siredmar/tfp401_board/README.md

tfp401_board
============

Hard- and Software for TFP401 Board to connect with 40 Pin RGB LCDs
