siredmar/tfp401_board/hw/tfp401_board/tfp401_board.brd

## EAGLE design hw/tfp401_board/tfp401_board.brd (2014-12-05)

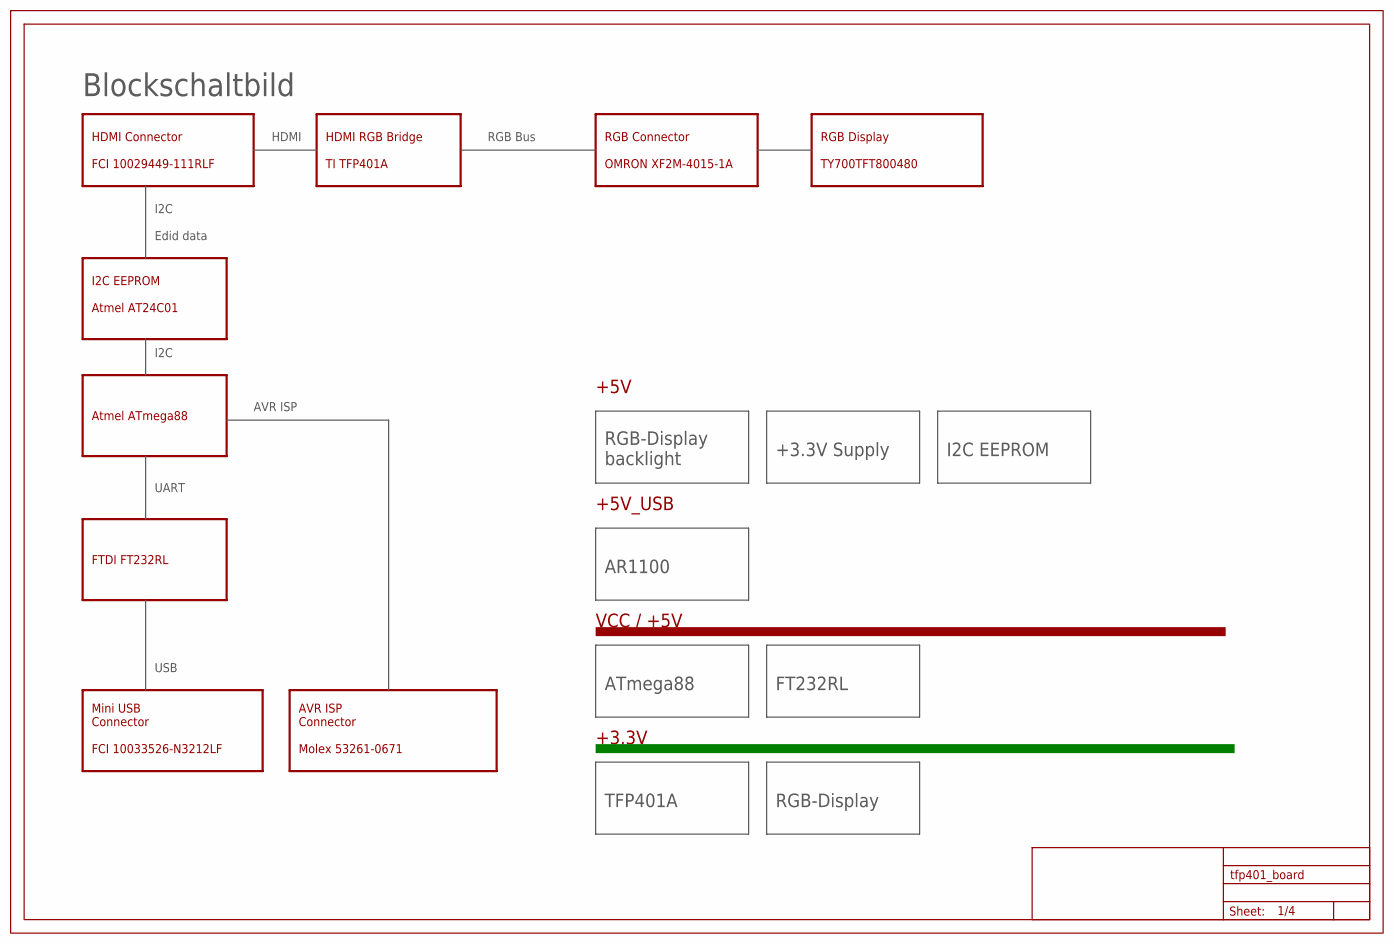
[picture p1: schematic tfp401_board.sch, sheet 1]

Parts:
U$15: FRAME_A3_LANDSCAPE; FRAME

Notes on the sheet:
HDMI Connector FCI 10029449-111RLF
RGB Display TY700TFT800480
Mini USB Connector FCI 10033526-N3212LF
AVR ISP Connector Molex 53261-0671
RGB Connector OMRON XF2M-4015-1A
HDMI RGB Bridge TI TFP401A
I2C EEPROM Atmel AT24C01
Atmel ATmega88
Edid data
RGB Bus
I2C
USB
AVR ISP
HDMI
Blockschaltbild
+3.3V
VCC / +5V
ATmega88
I2C EEPROM
FT232RL
TFP401A
FTDI FT232RL
UART
RGB-Display backlight
RGB-Display
+5V
AR1100
+5V_USB
+3.3V Supply

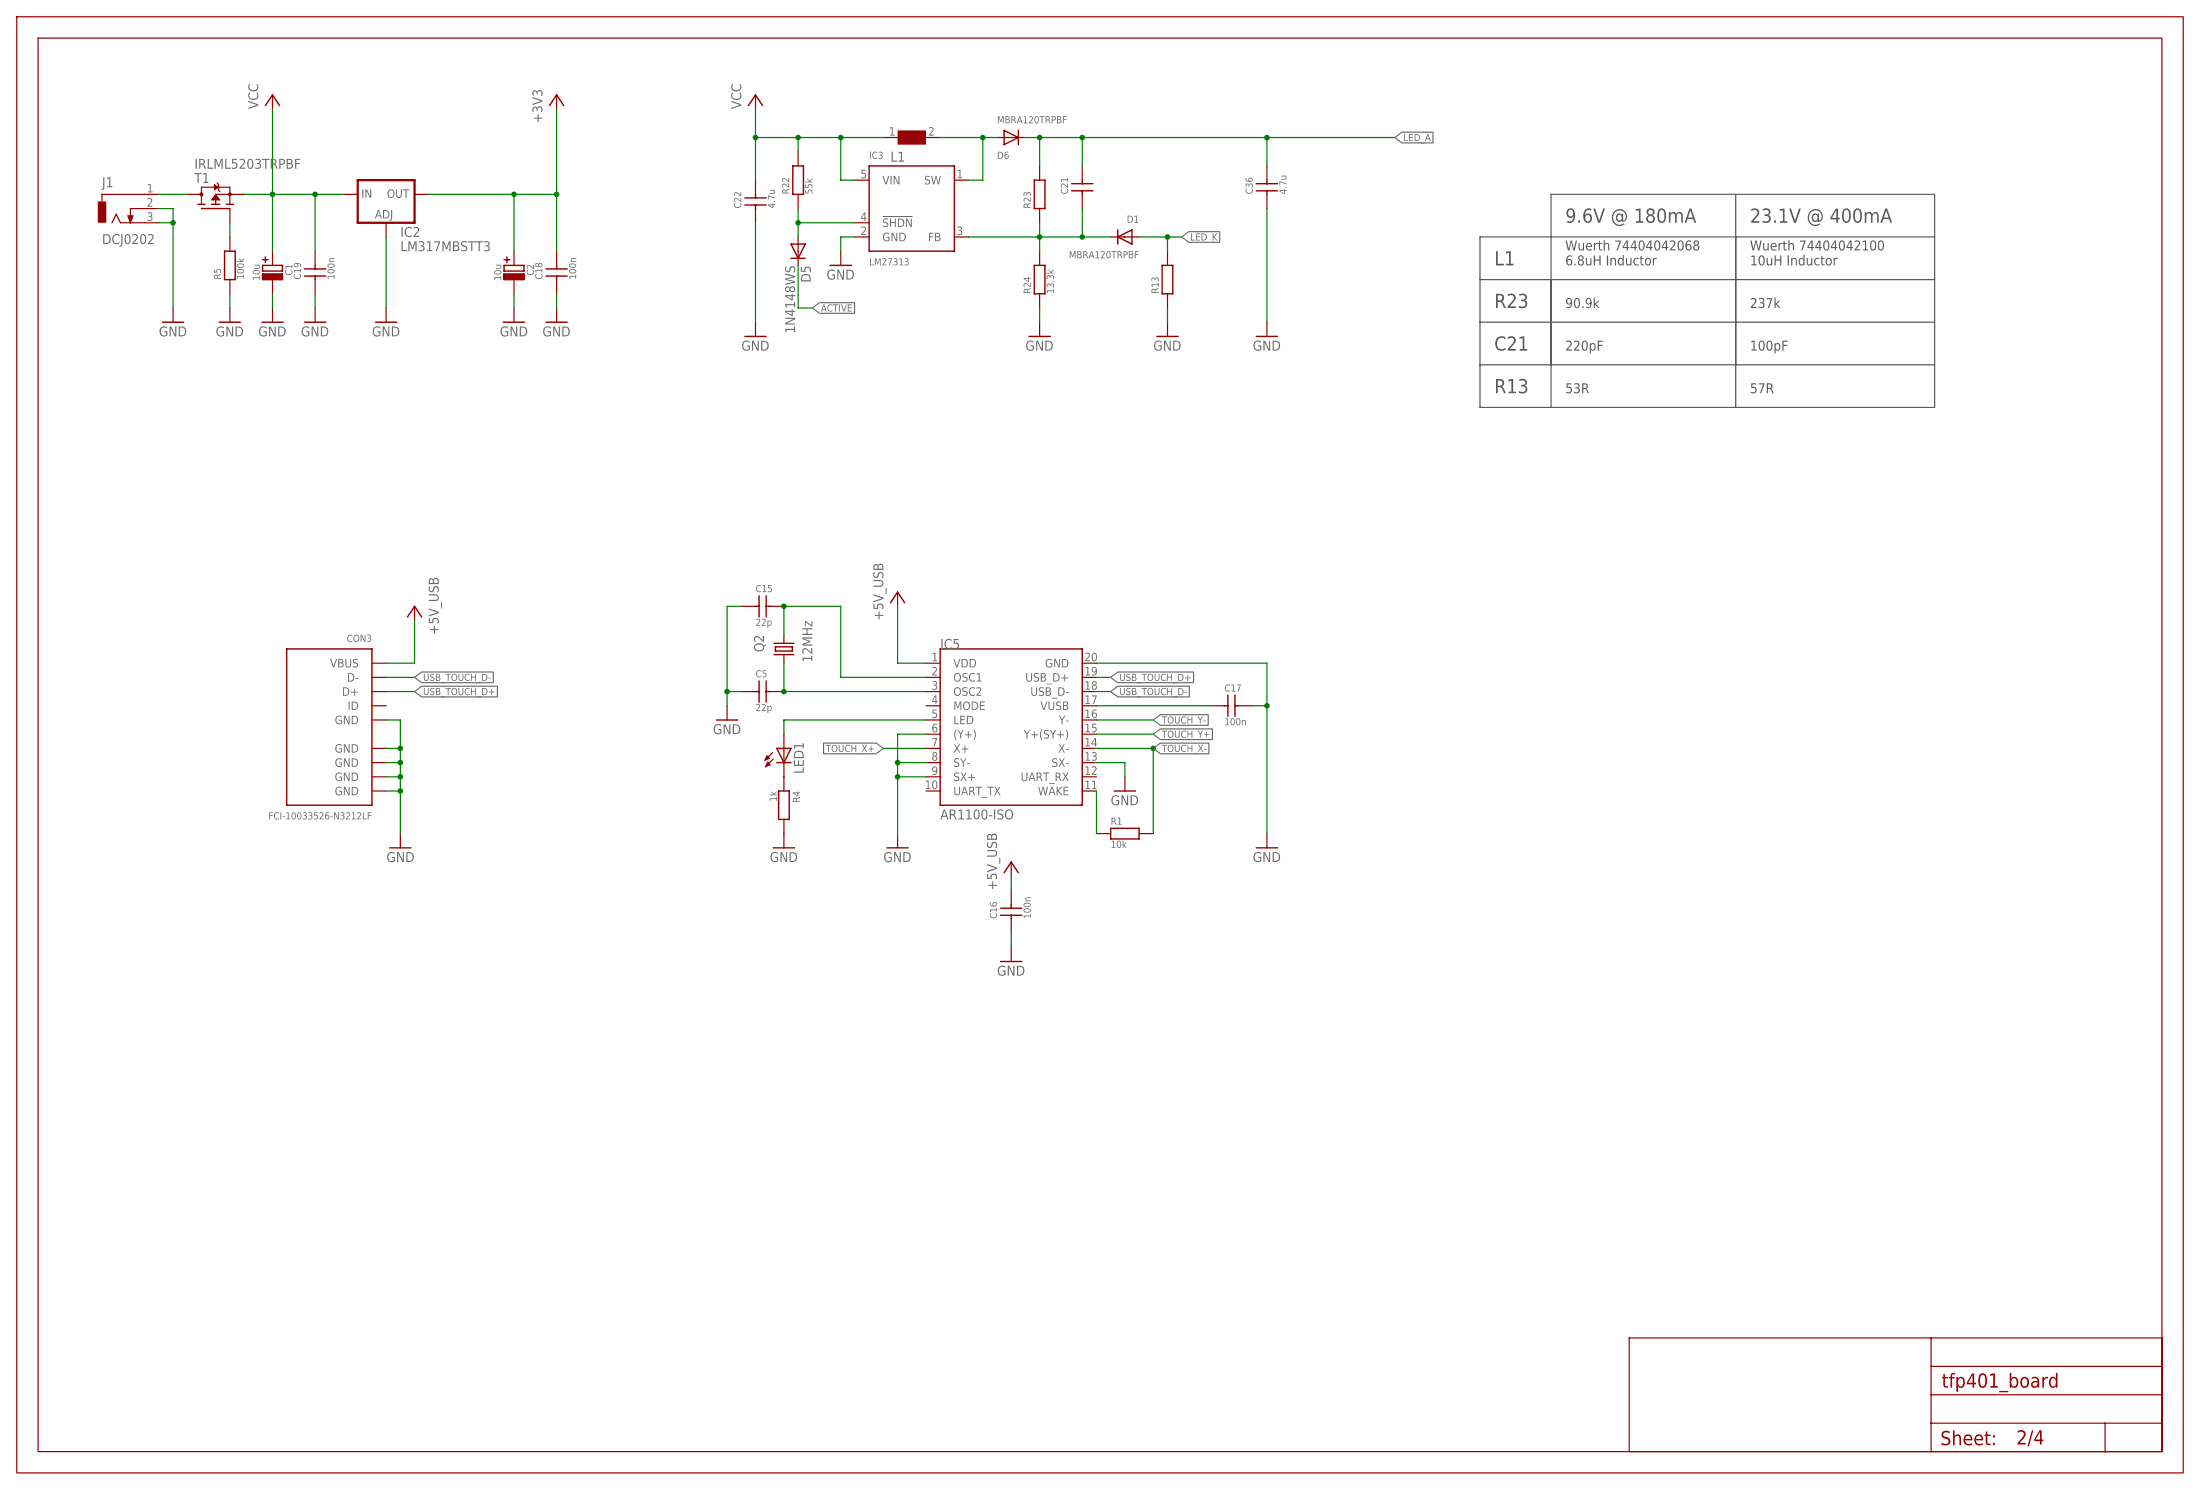
[picture p2: schematic tfp401_board.sch, sheet 2]

Parts:
C1, C2: 10u; C_POL_4X4MM
C5, C15: 22p; C0603
C16, C17, C18, C19: 100n; C0603
C21: C_SMD0603; C0603
C22, C36: 4.7u; C1206
CON3: FCI-10033526-N3212LF
D1, D6: MBRA120TRPBF; SMADIODE
D5: 1N4148WS; SOD323-W
IC2: LM317MBSTT3; SOT223
IC3: LM27313; SOT23-5
IC5: AR1100-ISO; SOIC20
J1: DCJ0202
L1: WE-LQS_4018
LED1: LEDCHIP-LED0805; CHIP-LED0805
Q2: 12MHz; HC49/USSM
R1: 10k; R0603
R4: 1k; R0603
R5: 100k; R0603
R13: R2512
R22: 55k; R0603
R23: R0603
R24: 13.3k; R0603
T1: IRLML5203TRPBF; SOT23
U$2: FRAME_A3_LANDSCAPE; FRAME

Connections:
+3V3: C2.+, C18.2, IC2.4 (OUT); also elsewhere on the board
+5V_USB: C16.2, CON3.1 (VBUS), IC5.1 (VDD)
ACTIVE: D5.C; also elsewhere on the board
GND: C1.-, C2.-, C5.1, C15.1, C16.1, C17.2, C18.1, C19.1, C22.1, C36.1, CON3.5 (GND), CON3.GND@1 (GND), CON3.GND@2 (GND), CON3.GND@3 (GND), CON3.GND@4 (GND), IC2.1 (ADJ), IC3.2 (GND), IC5.6 ((Y+)), IC5.8 (SY-), IC5.9 (SX+), IC5.13 (SX-), IC5.20 (GND), J1.2, J1.3, R4.2, R5.1, R13.1, R24.1; also elsewhere on the board
LED_A: C21.2, C36.2, D6.C, R23.2; also elsewhere on the board
LED_K: D1.A, R13.2; also elsewhere on the board
unnamed: R5.2, T1.1 (G)
unnamed: IC5.11 (WAKE), R1.1
unnamed: C17.1, IC5.17 (VUSB)
unnamed: LED1.C, R4.1
unnamed: C15.2, IC5.2 (OSC1), Q2.1
unnamed: J1.1, T1.3 (D)
unnamed: C5.2, IC5.3 (OSC2), Q2.2
unnamed: D6.A, IC3.1 (SW), L1.2
unnamed: D5.A, IC3.4 (!SHDN), R22.1
unnamed: IC5.5 (LED), LED1.A
unnamed: C21.1, D1.C, IC3.3 (FB), R23.1, R24.2
TOUCH_X+: IC5.7 (X+); also elsewhere on the board
TOUCH_X-: IC5.14 (X-), R1.2; also elsewhere on the board
TOUCH_Y+: IC5.15 (Y+(SY+)); also elsewhere on the board
TOUCH_Y-: IC5.16 (Y-); also elsewhere on the board
USB_TOUCH_D+: CON3.3 (D+), IC5.19 (USB_D+)
USB_TOUCH_D-: CON3.2 (D-), IC5.18 (USB_D-)
VCC: C1.+, C19.2, C22.2, IC2.3 (IN), IC3.5 (VIN), L1.1, R22.2, T1.2 (S); also elsewhere on the board

Notes on the sheet:
9.6V @ 180mA
23.1V @ 400mA
R23
Wuerth 74404042068 6.8uH Inductor
Wuerth 74404042100 10uH Inductor
C21
90.9k
237k
100pF
220pF
R13
57R
53R

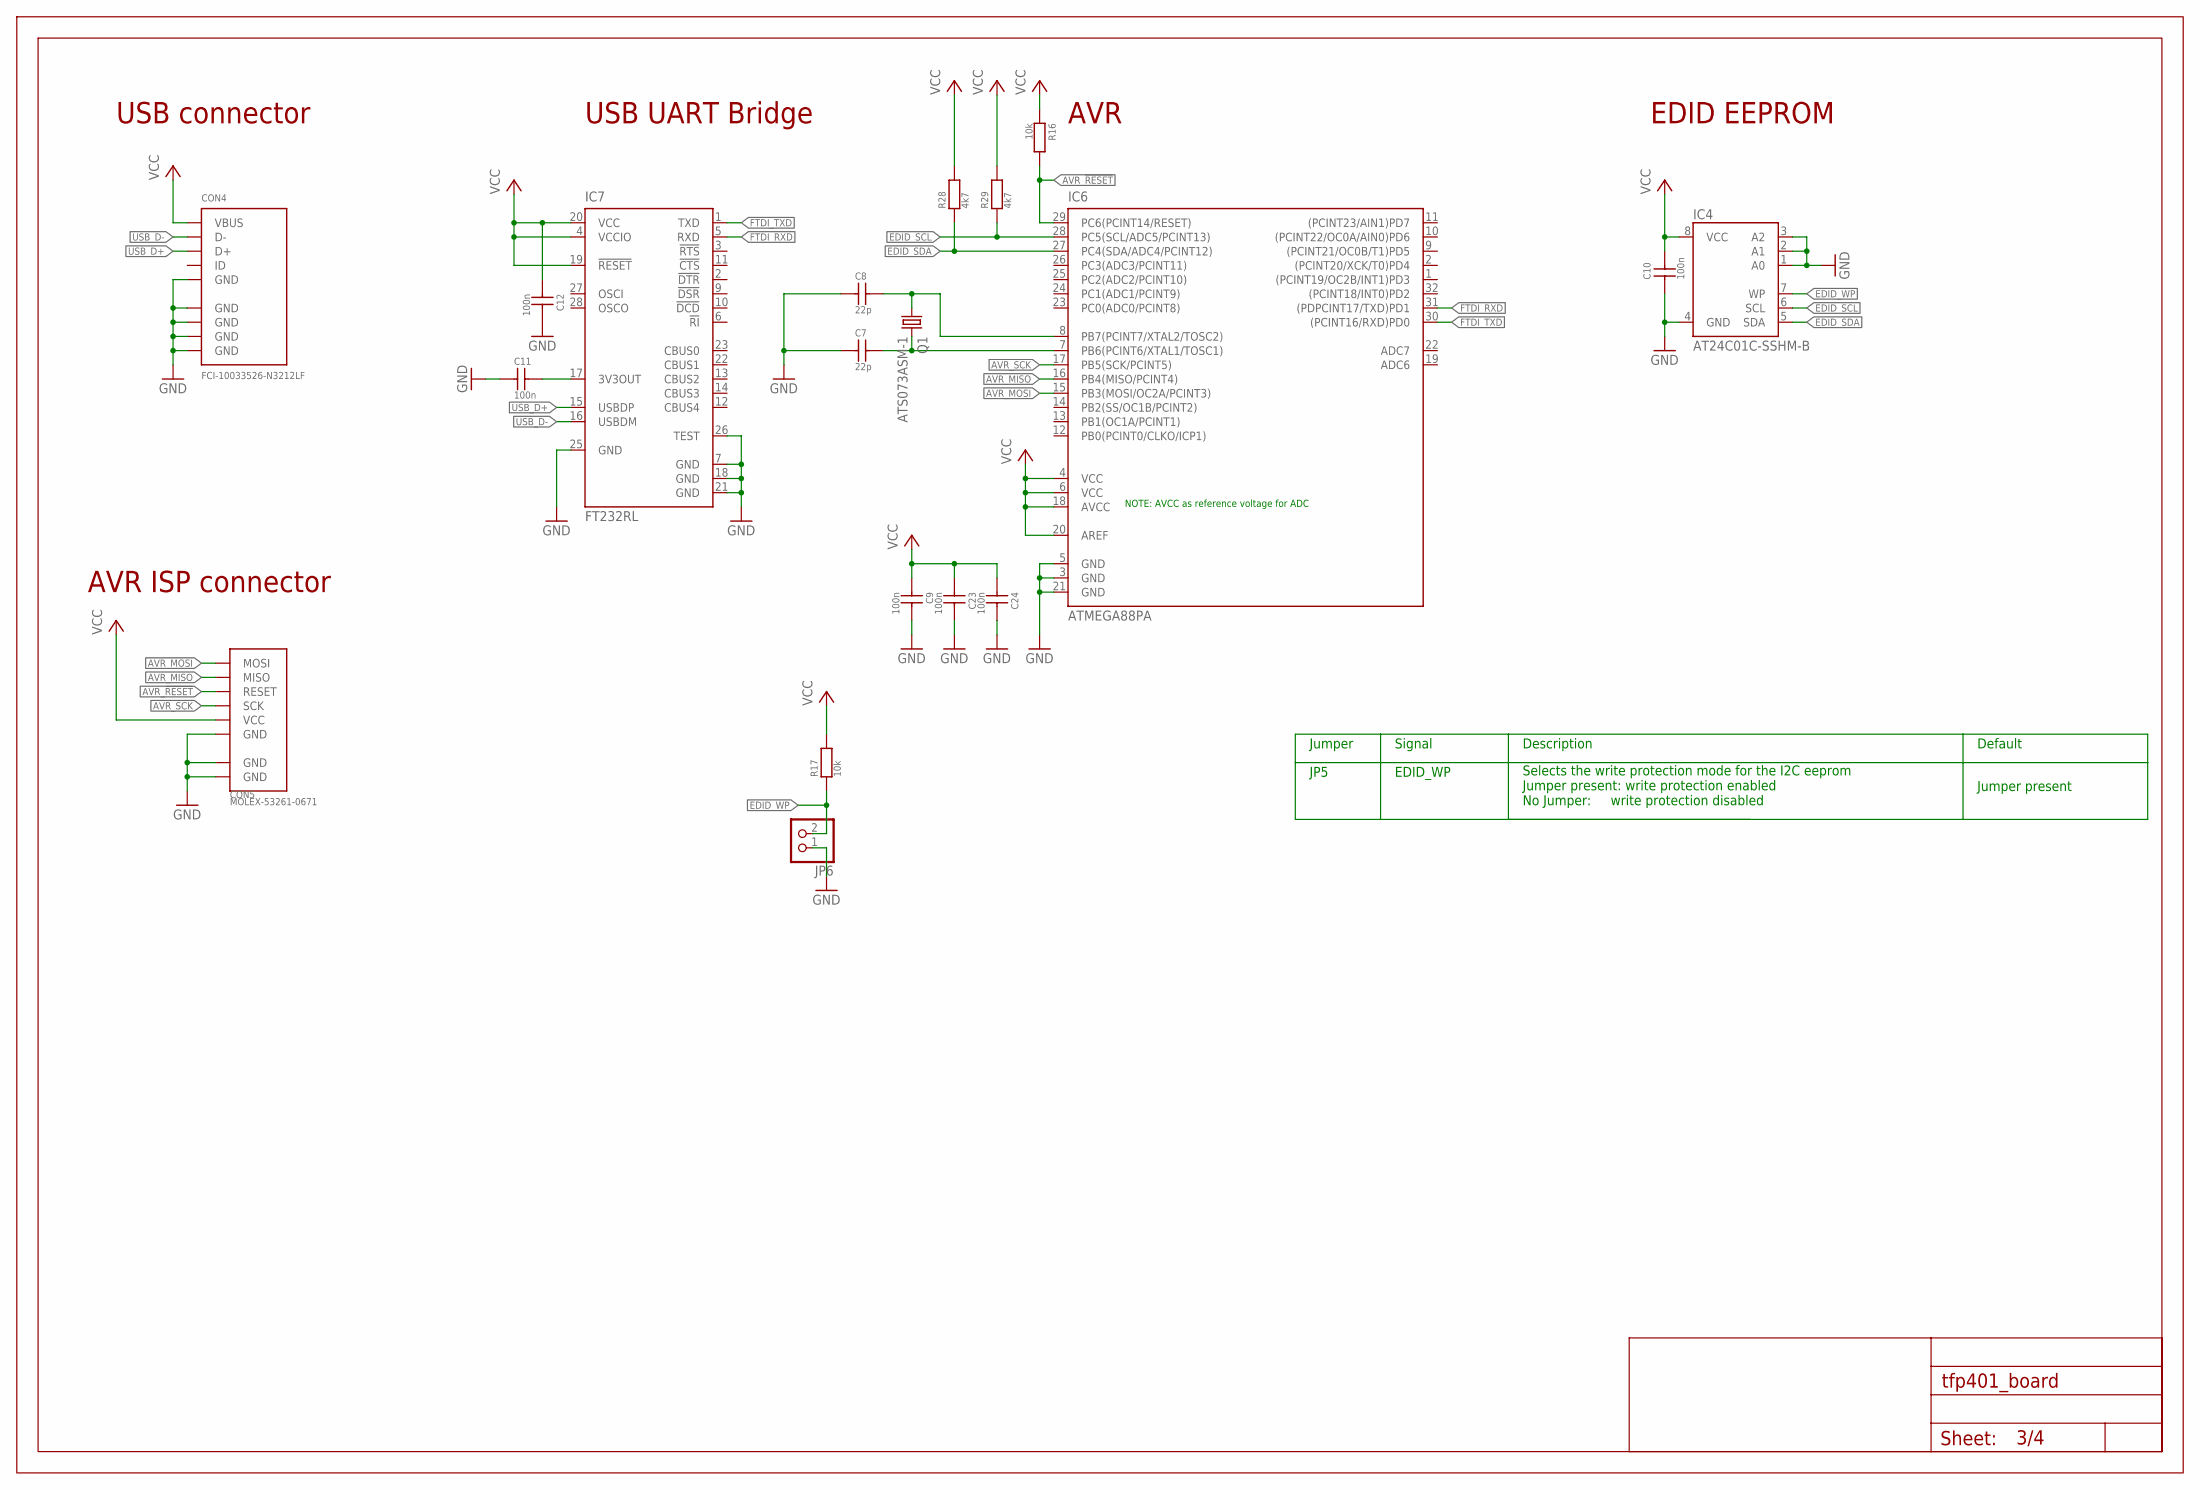
[picture p3: schematic tfp401_board.sch, sheet 3]

Parts:
C7, C8: 22p; C0603
C9, C10, C11, C12, C23, C24: 100n; C0603
CON4: FCI-10033526-N3212LF
CON5: MOLEX-53261-0671
IC4: AT24C01C-SSHM-B; SOIC8
IC6: ATMEGA88PA; TQFP32
IC7: FT232RL; SSOP28
JP6: PINHD-1X02_2.54-SMD-90°; 1X02SMD/90
Q1: ATS073ASM-1; HC49/USSM
R16, R17: 10k; R0603
R28, R29: 4k7; R0603
U$4: FRAME_A3_LANDSCAPE; FRAME

Connections:
AVR_!RESET: CON5.3 (RESET), IC6.29 (PC6(PCINT14/RESET)), R16.2
AVR_MISO: CON5.2 (MISO), IC6.16 (PB4(MISO/PCINT4))
AVR_MOSI: CON5.1 (MOSI), IC6.15 (PB3(MOSI/OC2A/PCINT3))
AVR_SCK: CON5.4 (SCK), IC6.17 (PB5(SCK/PCINT5))
AVR_XTAL1: C7.2, IC6.7 (PB6(PCINT6/XTAL1/TOSC1)), Q1.2
AVR_XTAL2: C8.2, IC6.8 (PB7(PCINT7/XTAL2/TOSC2)), Q1.1
EDID_SCL: IC4.6 (SCL), IC6.28 (PC5(SCL/ADC5/PCINT13)), R29.1; also elsewhere on the board
EDID_SDA: IC4.5 (SDA), IC6.27 (PC4(SDA/ADC4/PCINT12)), R28.1; also elsewhere on the board
EDID_WP: IC4.7 (WP), JP6.2, R17.1
FTDI_3V3OUT: C11.2, IC7.17 (3V3OUT)
FTDI_RXD: IC6.31 ((PDPCINT17/TXD)PD1), IC7.5 (RXD)
FTDI_TXD: IC6.30 ((PCINT16/RXD)PD0), IC7.1 (TXD)
GND: C7.1, C8.1, C9.2, C10.1, C11.1, C12.2, C23.2, C24.2, CON4.5 (GND), CON4.GND@1 (GND), CON4.GND@2 (GND), CON4.GND@3 (GND), CON4.GND@4 (GND), CON5.6 (GND), CON5.GND@1 (GND), CON5.GND@2 (GND), IC4.1 (A0), IC4.2 (A1), IC4.3 (A2), IC4.4 (GND), IC6.3 (GND), IC6.5 (GND), IC6.21 (GND), IC7.7 (GND), IC7.18 (GND), IC7.21 (GND), IC7.25 (GND), IC7.26 (TEST), JP6.1; also elsewhere on the board
USB_D+: CON4.3 (D+), IC7.15 (USBDP)
USB_D-: CON4.2 (D-), IC7.16 (USBDM)
VCC: C9.1, C10.2, C12.1, C23.1, C24.1, CON4.1 (VBUS), CON5.5 (VCC), IC4.8 (VCC), IC6.4 (VCC), IC6.6 (VCC), IC6.18 (AVCC), IC6.20 (AREF), IC7.4 (VCCIO), IC7.19 (!RESET), IC7.20 (VCC), R16.1, R17.2, R28.2, R29.2; also elsewhere on the board

Notes on the sheet:
NOTE: AVCC as reference voltage for ADC
JP5
Jumper
Description
Signal
EDID_WP
Selects the write protection mode for the I2C eeprom Jumper present: write protection enabled No Jumper: write protection disabled
Default
Jumper present
EDID EEPROM
AVR
USB UART Bridge
AVR ISP connector
USB connector

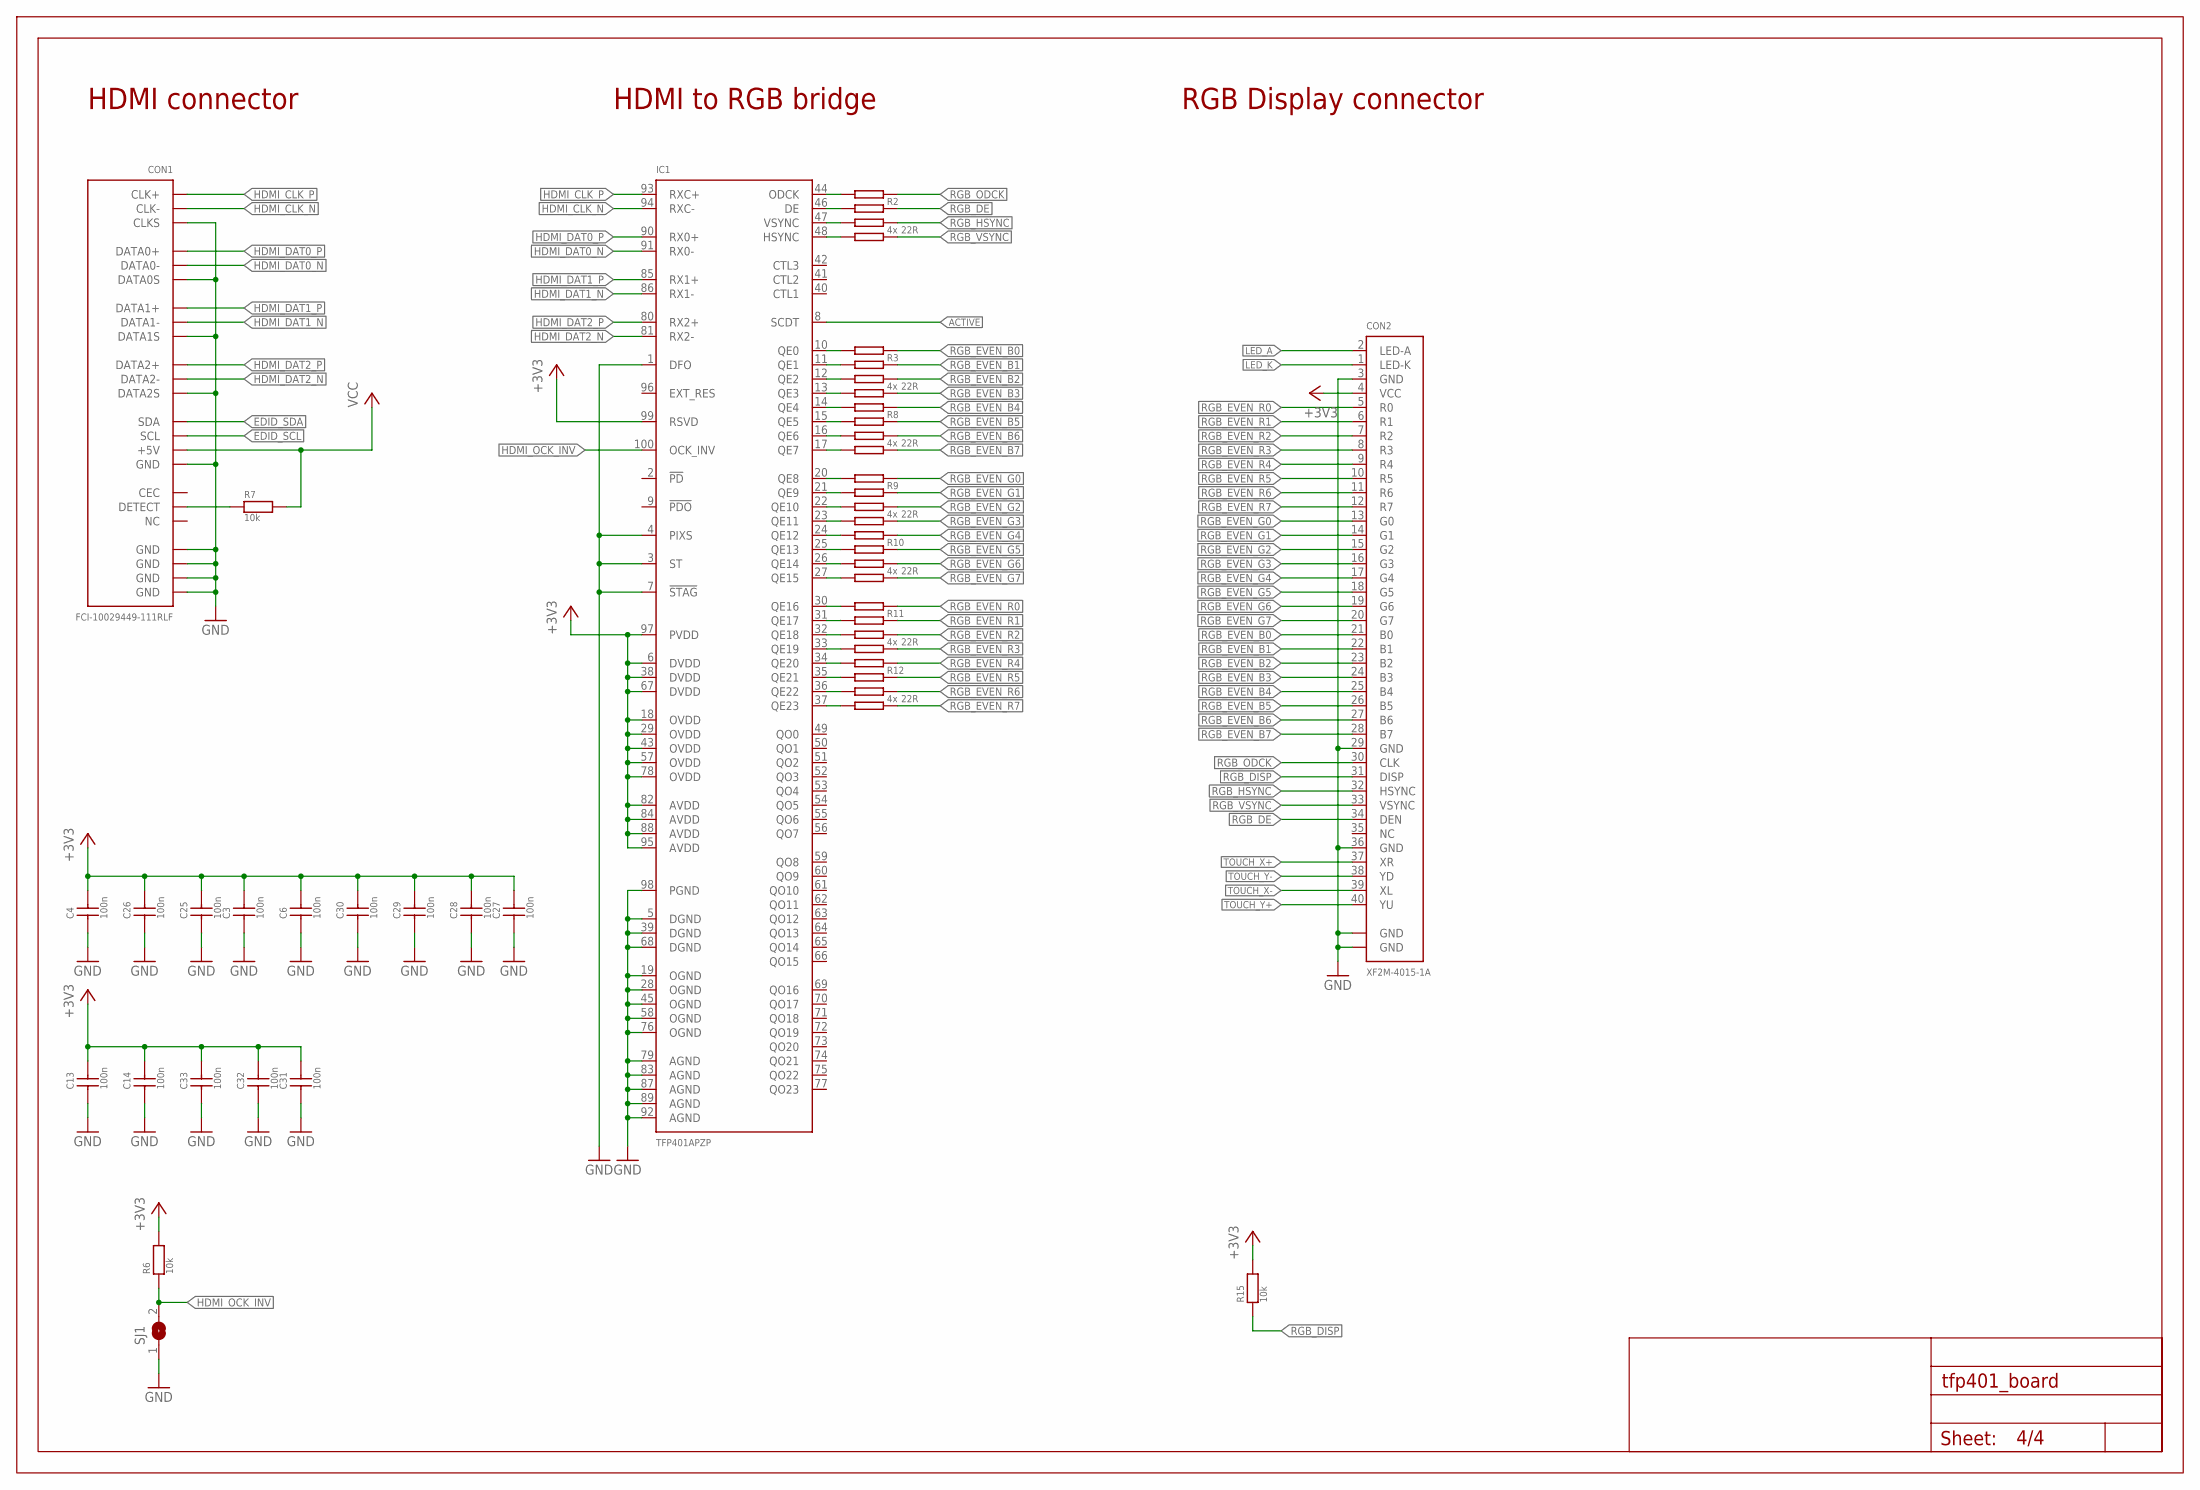
[picture p4: schematic tfp401_board.sch, sheet 4]

Parts:
C3, C4, C6, C13, C14, C25, C26, C27, C28, C29, C30, C31, C32, C33: 100n; C0603
CON1: FCI-10029449-111RLF
CON2: XF2M-4015-1A
IC1: TFP401APZP; HTQFP-100
R2, R3, R8, R9, R10, R11, R12: 22R; R-ARRAY-4X0603
R6, R7, R15: 10k; R0603
SJ1: SJ
U$1: FRAME_A3_LANDSCAPE; FRAME

Connections:
+3V3: C3.2, C4.2, C6.2, C13.2, C14.2, C25.2, C26.2, C27.2, C28.2, C29.2, C30.2, C31.2, C32.2, C33.2, CON2.4 (VCC), IC1.6 (DVDD), IC1.18 (OVDD), IC1.29 (OVDD), IC1.38 (DVDD), IC1.43 (OVDD), IC1.57 (OVDD), IC1.67 (DVDD), IC1.78 (OVDD), IC1.82 (AVDD), IC1.84 (AVDD), IC1.88 (AVDD), IC1.95 (AVDD), IC1.97 (PVDD), IC1.99 (RSVD), R6.2, R15.2; also elsewhere on the board
ACTIVE: IC1.8 (SCDT); also elsewhere on the board
EDID_SCL: CON1.15 (SCL); also elsewhere on the board
EDID_SDA: CON1.16 (SDA); also elsewhere on the board
GND: C3.1, C4.1, C6.1, C13.1, C14.1, C25.1, C26.1, C27.1, C28.1, C29.1, C30.1, C31.1, C32.1, C33.1, CON1.2 (DATA2S), CON1.5 (DATA1S), CON1.8 (DATA0S), CON1.11 (CLKS), CON1.17 (GND), CON1.GND@1 (GND), CON1.GND@2 (GND), CON1.GND@3 (GND), CON1.GND@4 (GND), CON2.3 (GND), CON2.29 (GND), CON2.36 (GND), CON2.GND@1 (GND), CON2.GND@2 (GND), IC1.1 (DFO), IC1.3 (ST), IC1.4 (PIXS), IC1.5 (DGND), IC1.7 (!STAG), IC1.19 (OGND), IC1.28 (OGND), IC1.39 (DGND), IC1.45 (OGND), IC1.58 (OGND), IC1.68 (DGND), IC1.76 (OGND), IC1.79 (AGND), IC1.83 (AGND), IC1.87 (AGND), IC1.89 (AGND), IC1.92 (AGND), IC1.98 (PGND), SJ1.1; also elsewhere on the board
HDMI_CLK_N: CON1.12 (CLK-), IC1.94 (RXC-)
HDMI_CLK_P: CON1.10 (CLK+), IC1.93 (RXC+)
HDMI_DAT0_N: CON1.9 (DATA0-), IC1.91 (RX0-)
HDMI_DAT0_P: CON1.7 (DATA0+), IC1.90 (RX0+)
HDMI_DAT1_N: CON1.6 (DATA1-), IC1.86 (RX1-)
HDMI_DAT1_P: CON1.4 (DATA1+), IC1.85 (RX1+)
HDMI_DAT2_N: CON1.3 (DATA2-), IC1.81 (RX2-)
HDMI_DAT2_P: CON1.1 (DATA2+), IC1.80 (RX2+)
HDMI_OCK_INV: IC1.100 (OCK_INV), R6.1, SJ1.2
INT_RGB_DE: IC1.46 (DE), R2.3M
INT_RGB_EVEN_B0: IC1.10 (QE0), R3.4M
INT_RGB_EVEN_B1: IC1.11 (QE1), R3.3M
INT_RGB_EVEN_B2: IC1.12 (QE2), R3.2M
INT_RGB_EVEN_B3: IC1.13 (QE3), R3.1M
INT_RGB_EVEN_B4: IC1.14 (QE4), R8.4M
INT_RGB_EVEN_B5: IC1.15 (QE5), R8.3M
INT_RGB_EVEN_B6: IC1.16 (QE6), R8.2M
INT_RGB_EVEN_B7: IC1.17 (QE7), R8.1M
INT_RGB_EVEN_G0: IC1.20 (QE8), R9.4M
INT_RGB_EVEN_G1: IC1.21 (QE9), R9.3M
INT_RGB_EVEN_G2: IC1.22 (QE10), R9.2M
INT_RGB_EVEN_G3: IC1.23 (QE11), R9.1M
INT_RGB_EVEN_G4: IC1.24 (QE12), R10.4M
INT_RGB_EVEN_G5: IC1.25 (QE13), R10.3M
INT_RGB_EVEN_G6: IC1.26 (QE14), R10.2M
INT_RGB_EVEN_G7: IC1.27 (QE15), R10.1M
INT_RGB_EVEN_R0: IC1.30 (QE16), R11.4M
INT_RGB_EVEN_R1: IC1.31 (QE17), R11.3M
INT_RGB_EVEN_R2: IC1.32 (QE18), R11.2M
INT_RGB_EVEN_R3: IC1.33 (QE19), R11.1M
INT_RGB_EVEN_R4: IC1.34 (QE20), R12.4M
INT_RGB_EVEN_R5: IC1.35 (QE21), R12.3M
INT_RGB_EVEN_R6: IC1.36 (QE22), R12.2M
INT_RGB_EVEN_R7: IC1.37 (QE23), R12.1M
INT_RGB_HSYNC: IC1.47 (VSYNC), R2.2M
INT_RGB_ODCK: IC1.44 (ODCK), R2.4M
INT_RGB_VSYNC: IC1.48 (HSYNC), R2.1M
LED_A: CON2.2 (LED-A); also elsewhere on the board
LED_K: CON2.1 (LED-K); also elsewhere on the board
unnamed: CON1.19 (DETECT), R7.1
RGB_DE: CON2.34 (DEN), R2.3P
RGB_DISP: CON2.31 (DISP), R15.1
RGB_EVEN_B0: CON2.21 (B0), R3.4P
RGB_EVEN_B1: CON2.22 (B1), R3.3P
RGB_EVEN_B2: CON2.23 (B2), R3.2P
RGB_EVEN_B3: CON2.24 (B3), R3.1P
RGB_EVEN_B4: CON2.25 (B4), R8.4P
RGB_EVEN_B5: CON2.26 (B5), R8.3P
RGB_EVEN_B6: CON2.27 (B6), R8.2P
RGB_EVEN_B7: CON2.28 (B7), R8.1P
RGB_EVEN_G0: CON2.13 (G0), R9.4P
RGB_EVEN_G1: CON2.14 (G1), R9.3P
RGB_EVEN_G2: CON2.15 (G2), R9.2P
RGB_EVEN_G3: CON2.16 (G3), R9.1P
RGB_EVEN_G4: CON2.17 (G4), R10.4P
RGB_EVEN_G5: CON2.18 (G5), R10.3P
RGB_EVEN_G6: CON2.19 (G6), R10.2P
RGB_EVEN_G7: CON2.20 (G7), R10.1P
RGB_EVEN_R0: CON2.5 (R0), R11.4P
RGB_EVEN_R1: CON2.6 (R1), R11.3P
RGB_EVEN_R2: CON2.7 (R2), R11.2P
RGB_EVEN_R3: CON2.8 (R3), R11.1P
RGB_EVEN_R4: CON2.9 (R4), R12.4P
RGB_EVEN_R5: CON2.10 (R5), R12.3P
RGB_EVEN_R6: CON2.11 (R6), R12.2P
RGB_EVEN_R7: CON2.12 (R7), R12.1P
RGB_HSYNC: CON2.32 (HSYNC), R2.2P
RGB_ODCK: CON2.30 (CLK), R2.4P
RGB_VSYNC: CON2.33 (VSYNC), R2.1P
TOUCH_X+: CON2.37 (XR); also elsewhere on the board
TOUCH_X-: CON2.39 (XL); also elsewhere on the board
TOUCH_Y+: CON2.40 (YU); also elsewhere on the board
TOUCH_Y-: CON2.38 (YD); also elsewhere on the board
VCC: CON1.18 (+5V), R7.2; also elsewhere on the board

Notes on the sheet:
HDMI connector
HDMI to RGB bridge
RGB Display connector

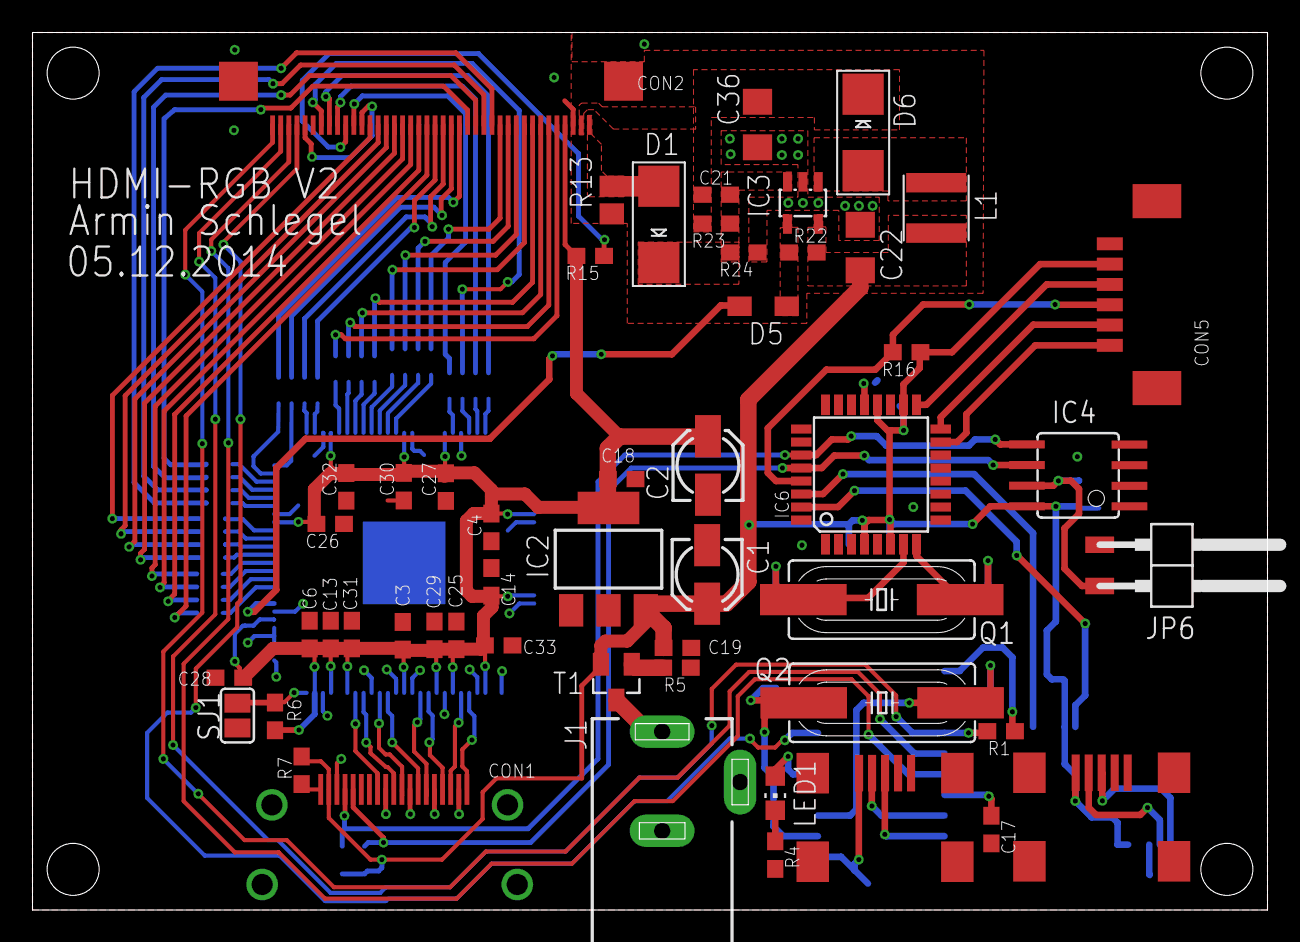
[picture p5: board tfp401_board.brd from above]

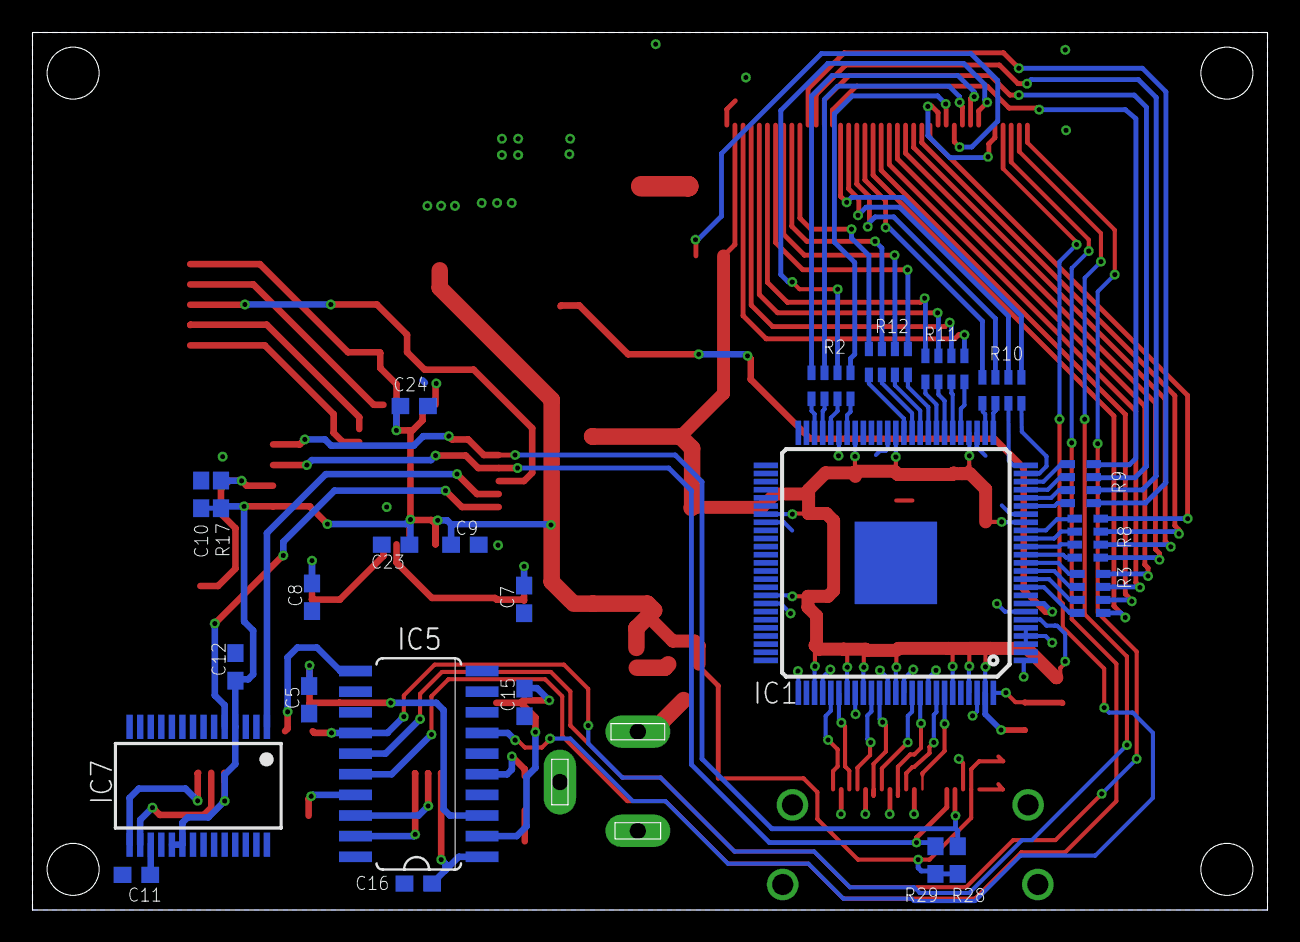
[picture p6: board tfp401_board.brd from below]

Board: 2 copper layers, 76.0 x 54.0 mm, 81 parts (24 on the bottom side), 105 nets.
