siredmar/tfp401_board/(notices)

Notices in the files:
parts and their libraries:
EagleLibrary_Wuerth_Elektronik_eiSos_V6_: Copyright: Würth Elektronik
